ChrisBall/ToffeePhonic/README.md

### ToffeePhonic

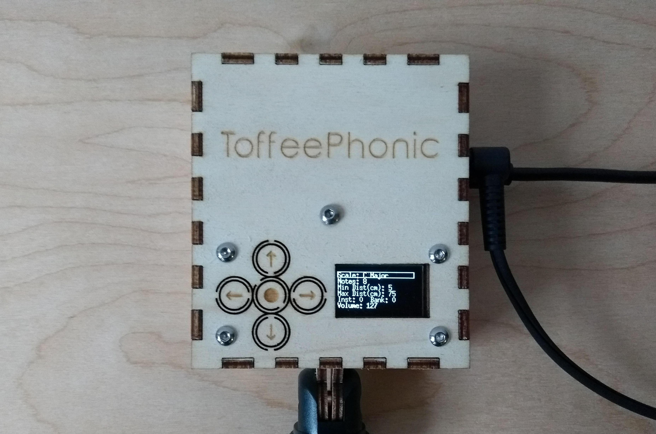
[picture p1: docs/img/000.jpg]
ToffeePhonic


ToffeePhonic is an open-source range sensing instrument. It measures distance using a Time-Of-Flight (TOF) sensor and converts the range into music with it's onboard synthesiser, or sends MIDI out over USB.

The instructions here should contain everything you need to build your own, including a bill of materials, laser cutting files, build guide, code and instructions for use. This project is probably not suitable for complete beginners (at the moment).

[Bill of materials](docs/BOM.md)

[Laser cutting files](docs/LaserFiles.md)

[Build guide](docs/Build.md)

[Code](docs/firmware/ToffeePhonic_basic)

[Instructions for use](docs/Instructions.md)

[This project on Github](https://github.com/ChrisBall/ToffeePhonic)

Development of the instrument and this guide has been part-funded by the wonderful [Drake Music](http://www.drakemusic.org/). No liability is assumed for anything! It is your responsibility to assess the safety and suitability of these instructions.
