ChrisBall/ToffeePhonic/docs/img/002.jpg

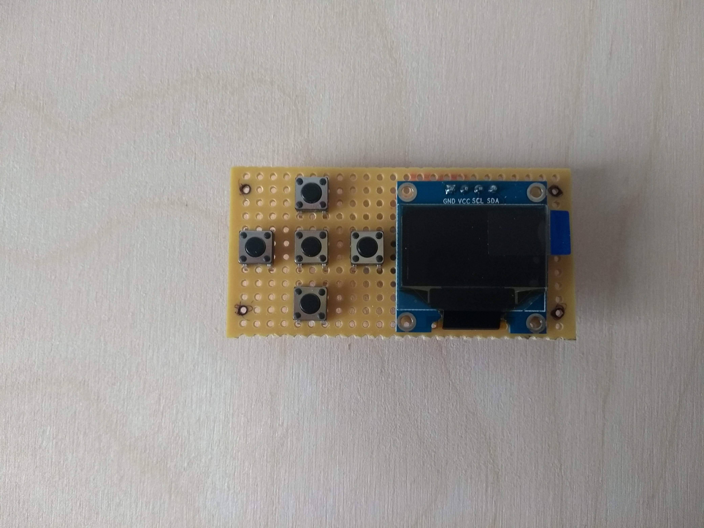
docs/img/002.jpg
