ChrisBall/ToffeePhonic/docs/img/032.jpg

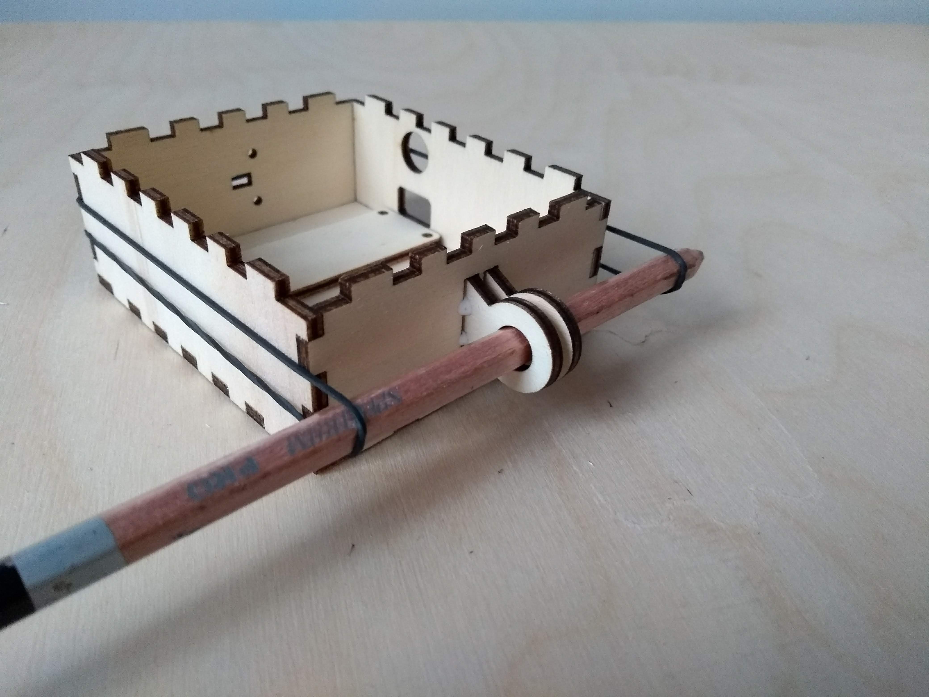
docs/img/032.jpg
