ChrisBall/ToffeePhonic/docs/img/IMG_20181012_145808522.jpg

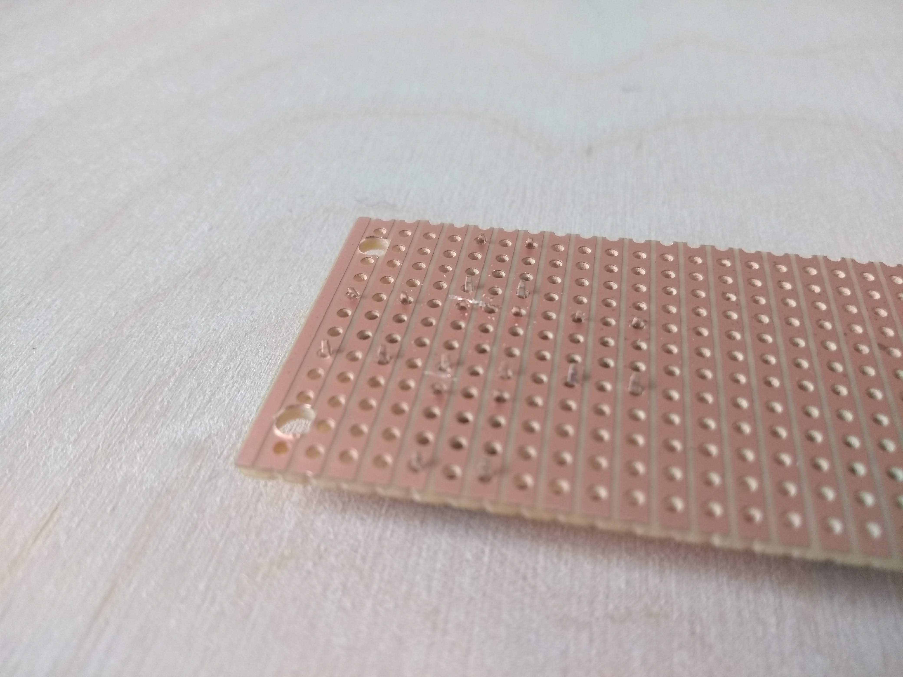
docs/img/IMG_20181012_145808522.jpg
