ChrisBall/ToffeePhonic/docs/img/IMG_20181021_133131997.jpg

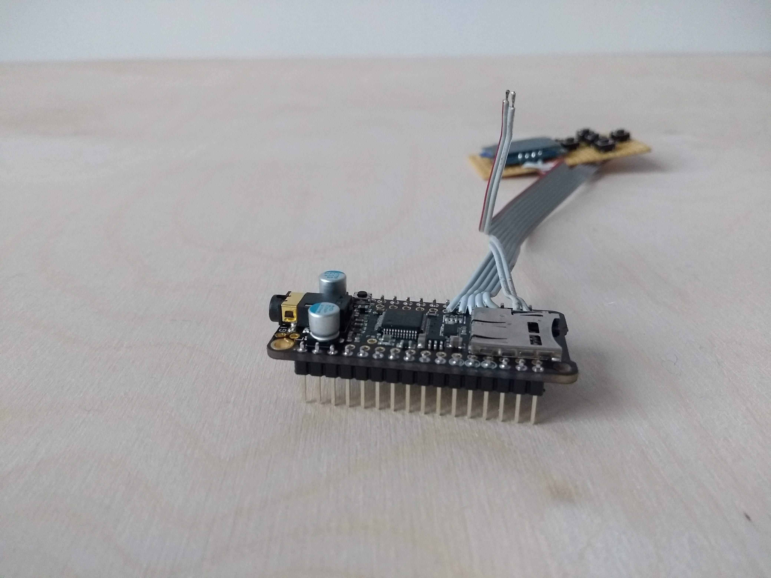
docs/img/IMG_20181021_133131997.jpg
