ChrisBall/ToffeePhonic/docs/img/IMG_20181021_134704607.jpg

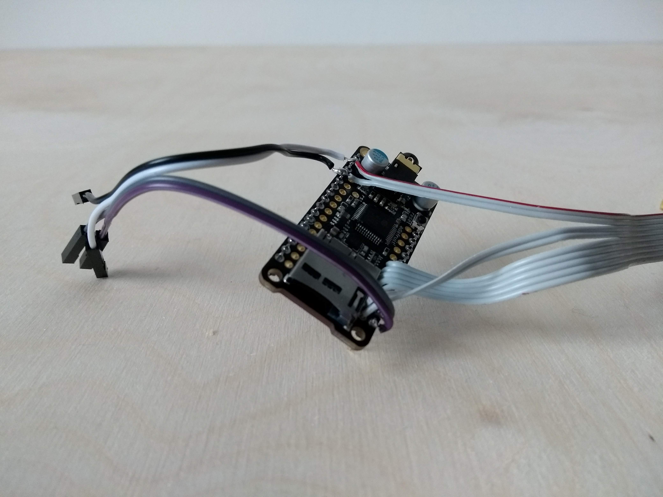
docs/img/IMG_20181021_134704607.jpg
