ChrisBall/ToffeePhonic/docs/img/IMG_20181021_134706835_HDR.jpg

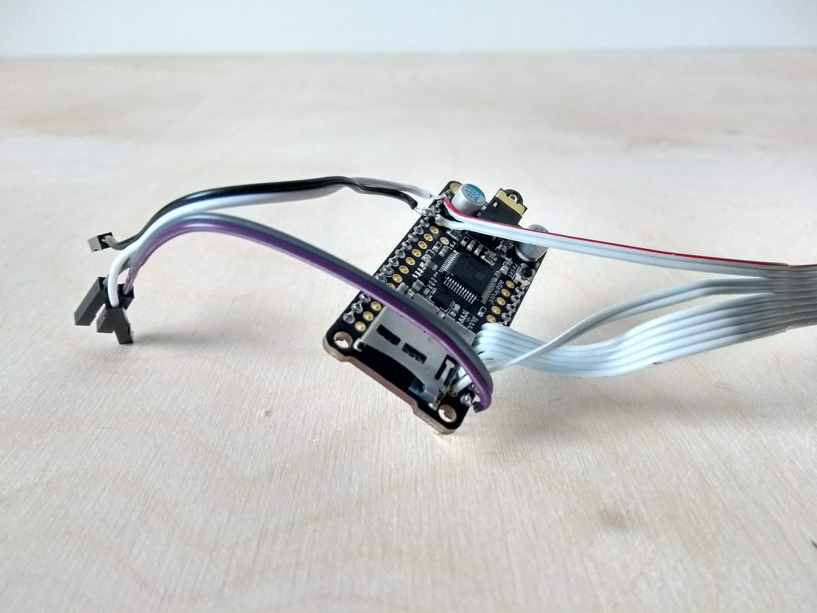
docs/img/IMG_20181021_134706835_HDR.jpg
