ChrisBall/ToffeePhonic/docs/img/IMG_20181021_134756472.jpg

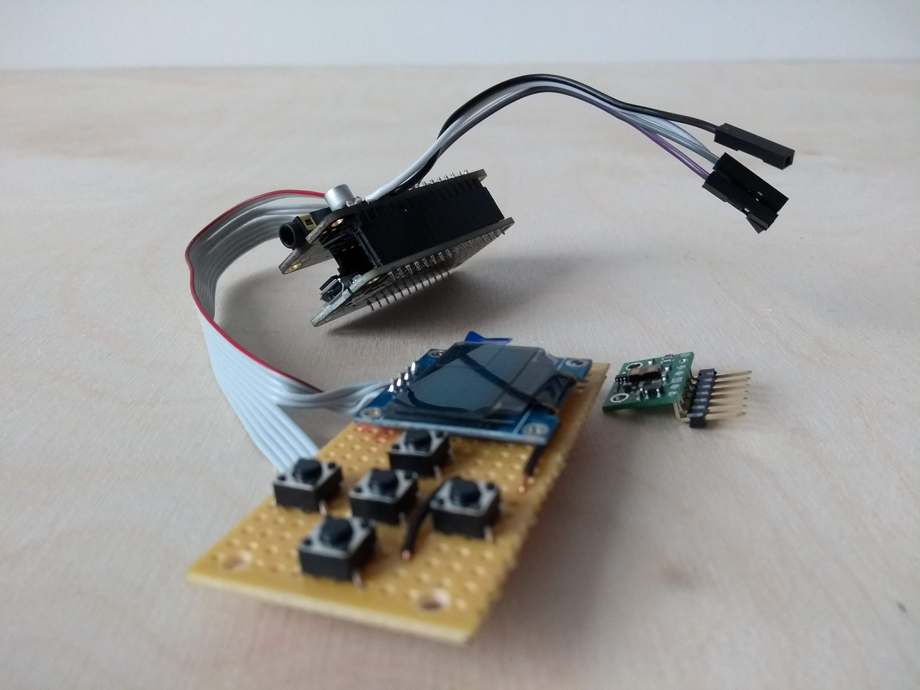
docs/img/IMG_20181021_134756472.jpg
