ChrisBall/ToffeePhonic/docs/img/IMG_20181021_134817264_HDR.jpg

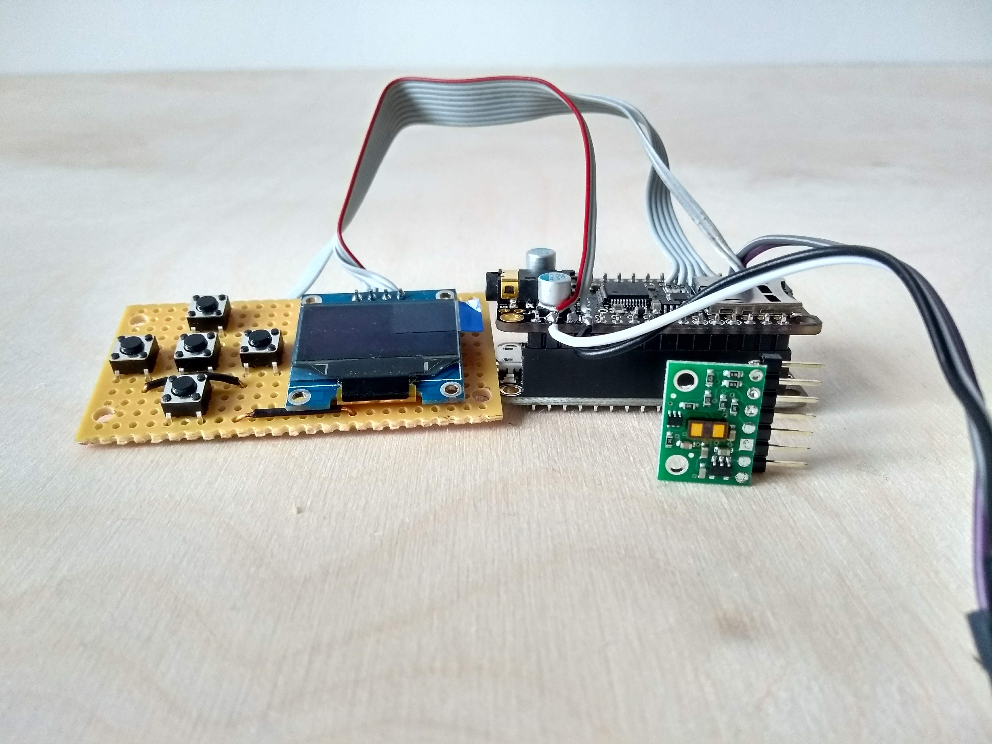
docs/img/IMG_20181021_134817264_HDR.jpg
