ChrisBall/ToffeePhonic/docs/img/IMG_20181021_154531694_HDR.jpg

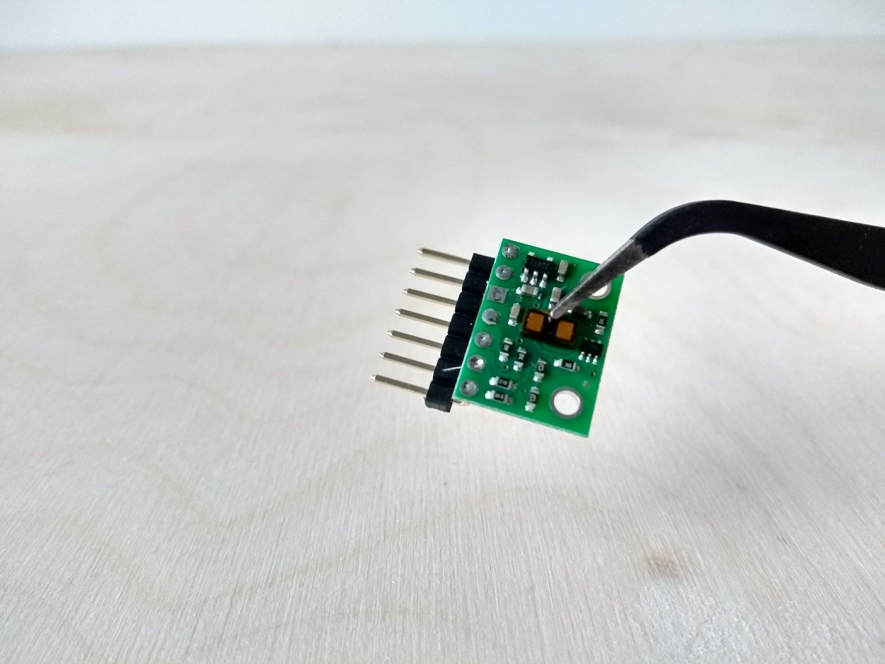
docs/img/IMG_20181021_154531694_HDR.jpg
