ChrisBall/ToffeePhonic/docs/img/IMG_20181021_161038249.jpg

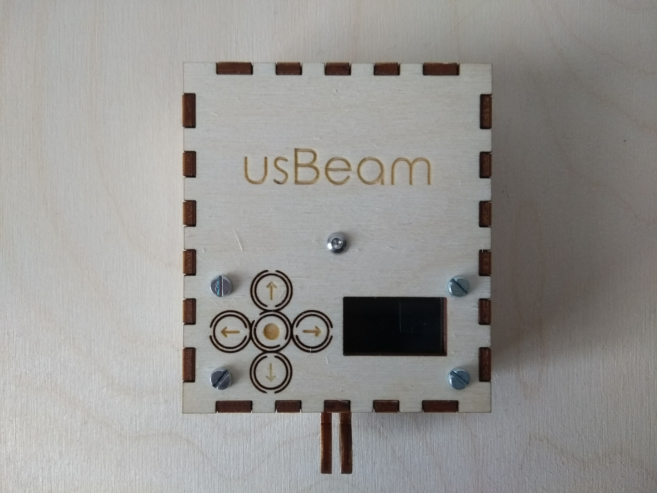
docs/img/IMG_20181021_161038249.jpg
