ChrisBall/ToffeePhonic/docs/img/IMG_20181021_161039607.jpg

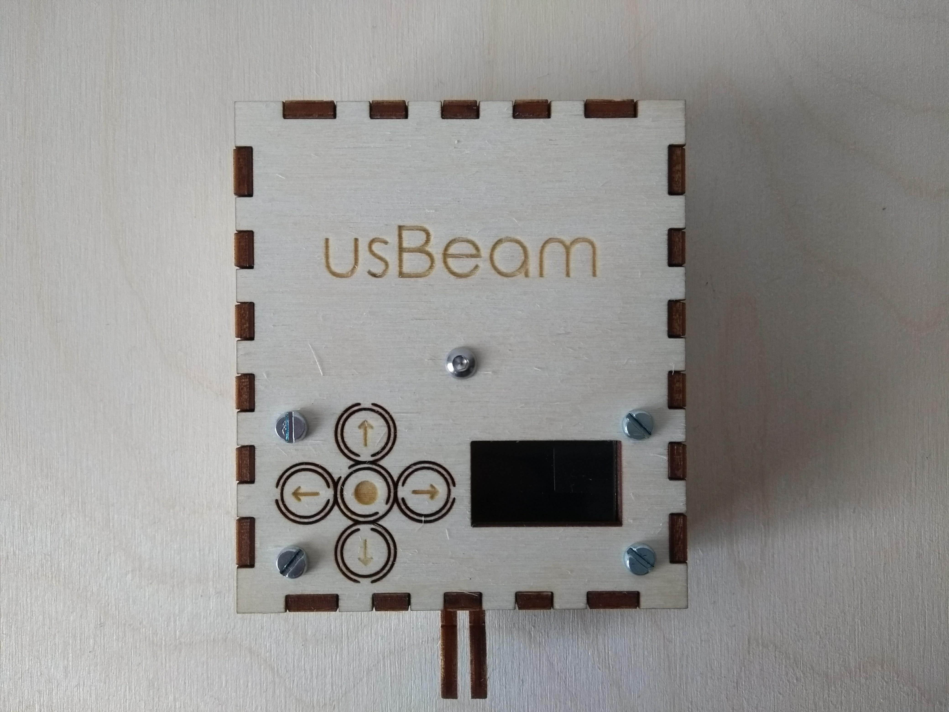
docs/img/IMG_20181021_161039607.jpg
