ChrisBall/ToffeePhonic/docs/img/IMG_20181021_161042068.jpg

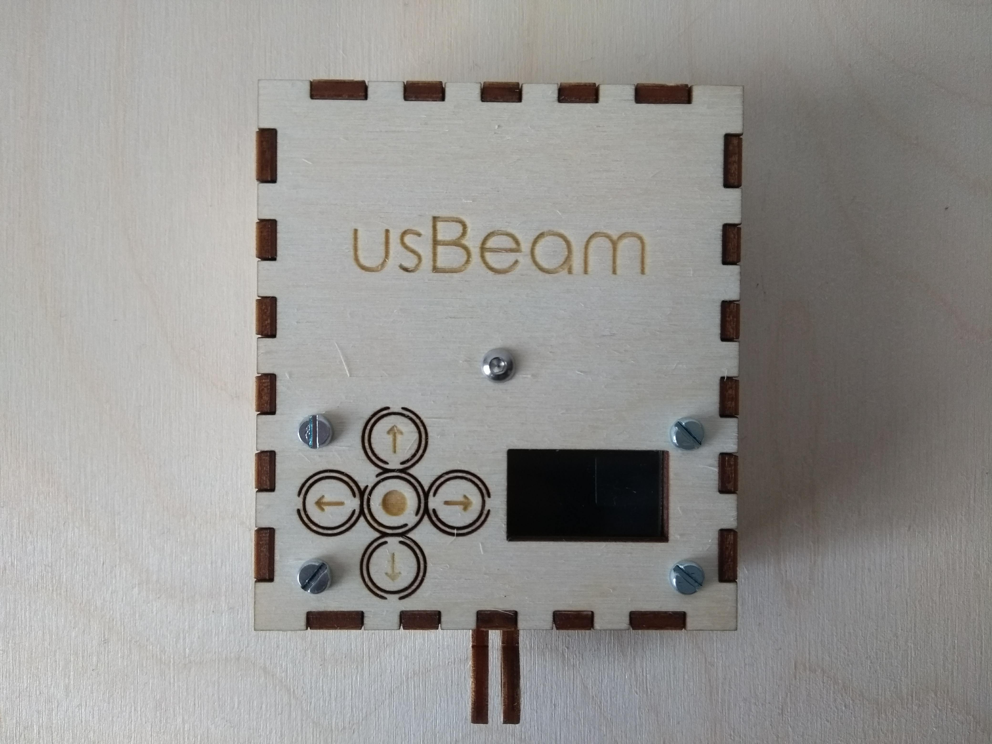
docs/img/IMG_20181021_161042068.jpg
