ChrisBall/ToffeePhonic/docs/img/IMG_20181021_161052201.jpg

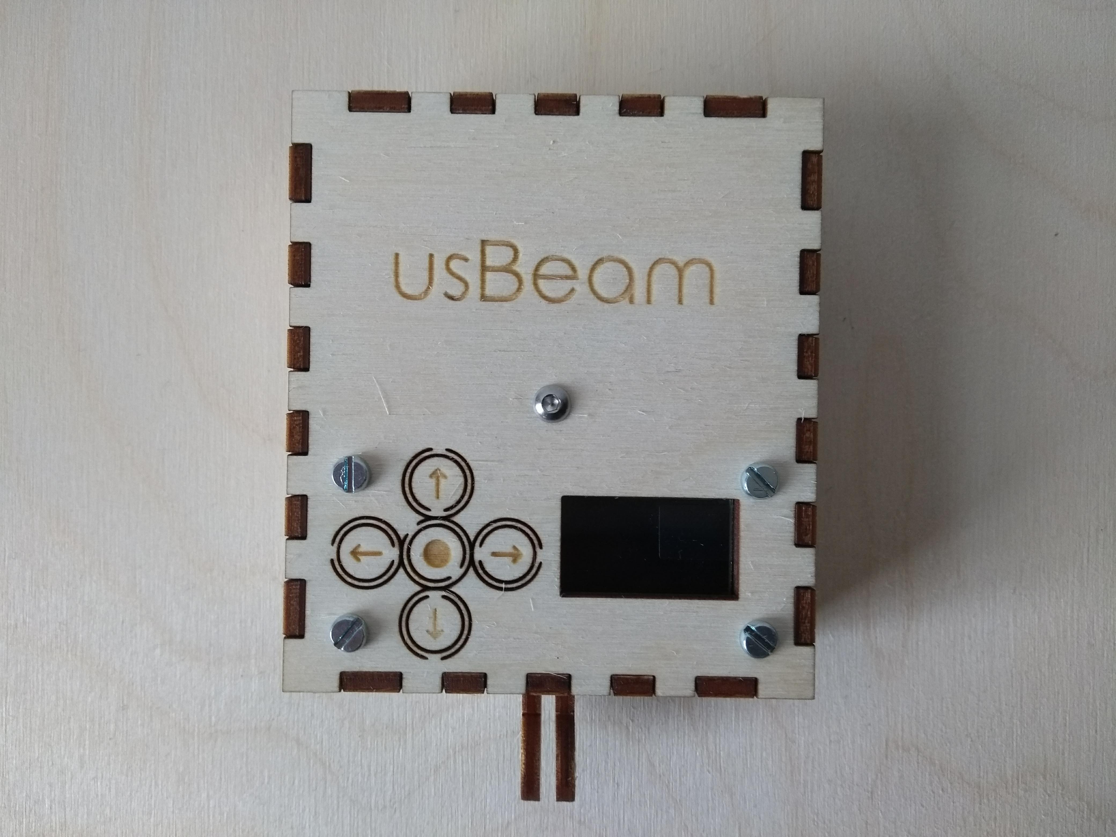
docs/img/IMG_20181021_161052201.jpg
