ChrisBall/ToffeePhonic/docs/img/IMG_20181021_161112957.jpg

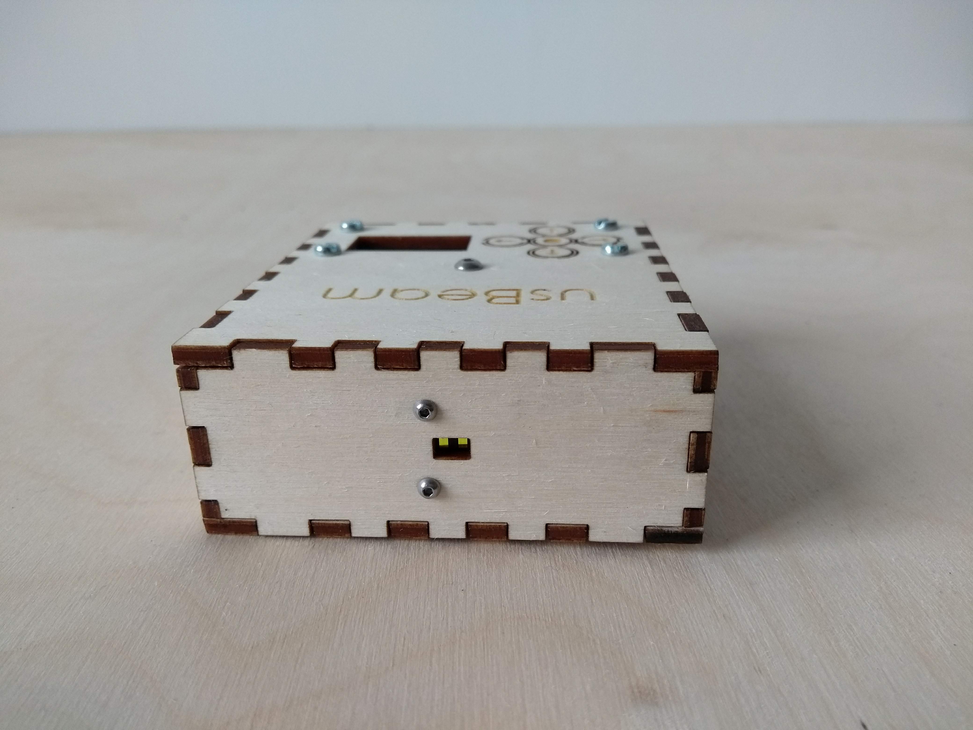
docs/img/IMG_20181021_161112957.jpg
