ChrisBall/ToffeePhonic/docs/img/IMG_20181109_150431618_BURST000_COVER_TOP.jpg

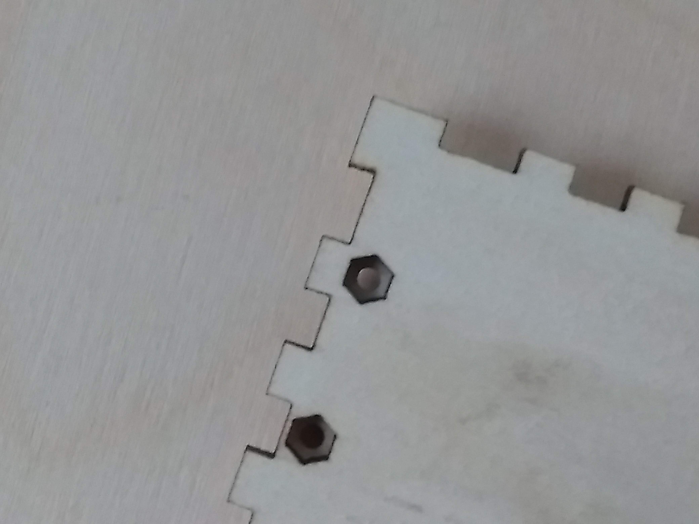
docs/img/IMG_20181109_150431618_BURST000_COVER_TOP.jpg
