ChrisBall/ToffeePhonic/docs/img/IMG_20181109_150909038.jpg

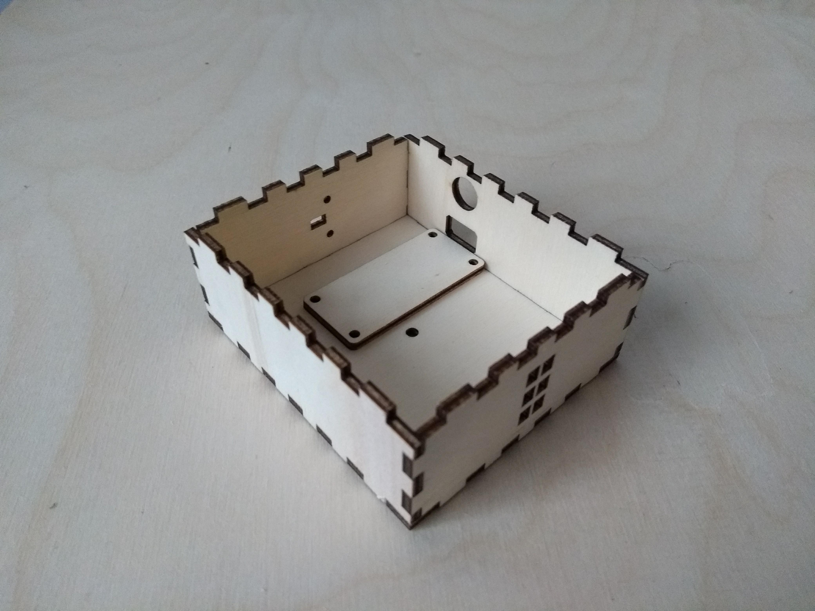
docs/img/IMG_20181109_150909038.jpg
