ChrisBall/ToffeePhonic/docs/Build.md

## Build guide

Menu Breakout (this will hopefully be replaced by a single PCB in future versions):

1. Cut/snap a piece of copper stripboard (0.1" spacing) so you have 24 x 12 holes to work with, with the strips running in the direction of the short sides. We will be placing the components on this board as shown.

    Component placing

2. Drill (to 3mm) the 4 holes at (1,2), (24,2), (1,11), and (24,11) - as pictured.

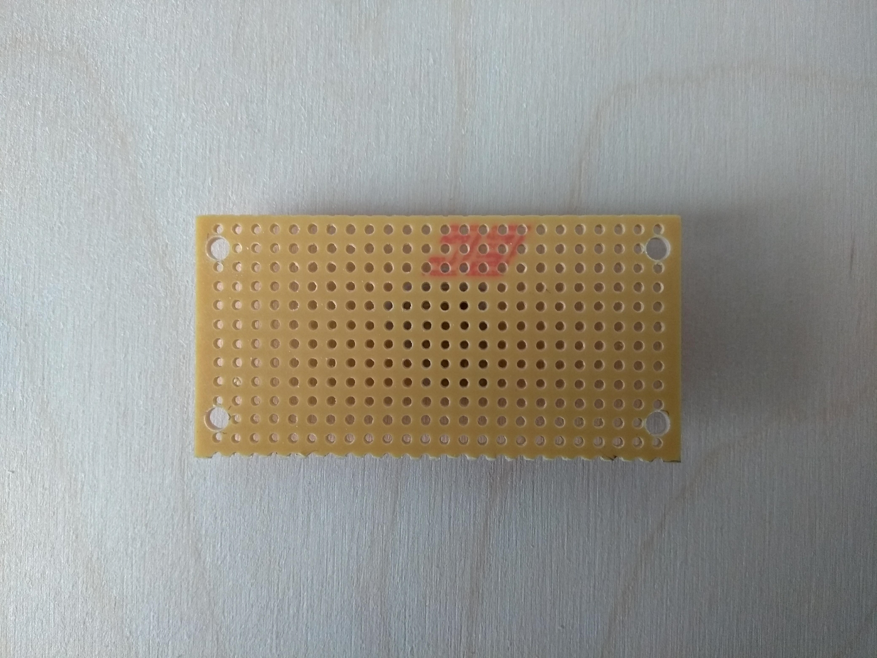
[picture p19: docs/img/001.jpg]
Drill 3mm holes in board
    

3. Put the buttons in place (don't solder them yet), with their top left pins in positions (1,5), (5,1), (5,5), (5,9), (9,5), as pictured in the first image.

4. Carefully, cut the copper tracks with the craft knife: between holes (5,4) and (5,5); and (5,8) and (5,9) (highlighted in the picture).

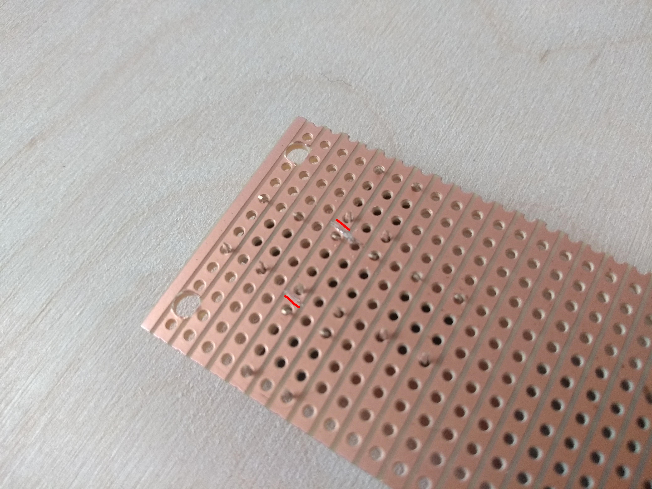
[picture p20: docs/img/004.jpg]
cutting tracks between buttons
    

5. Solder the buttons in place. Make sure they're flush with the board, and that the solder does not spill over the cut track.

6. Remove the plastic spacer from the I2C OLED display. Usually I begin by (carefully) levering this off with some wire cutters and pull it off with pliers once it's loose. Be warned - the glass corners of the OLED display are VERY fragile and can stop the display from functioning if broken. It's a good idea to inspect your display as you open it in case it's been damaged during transit.

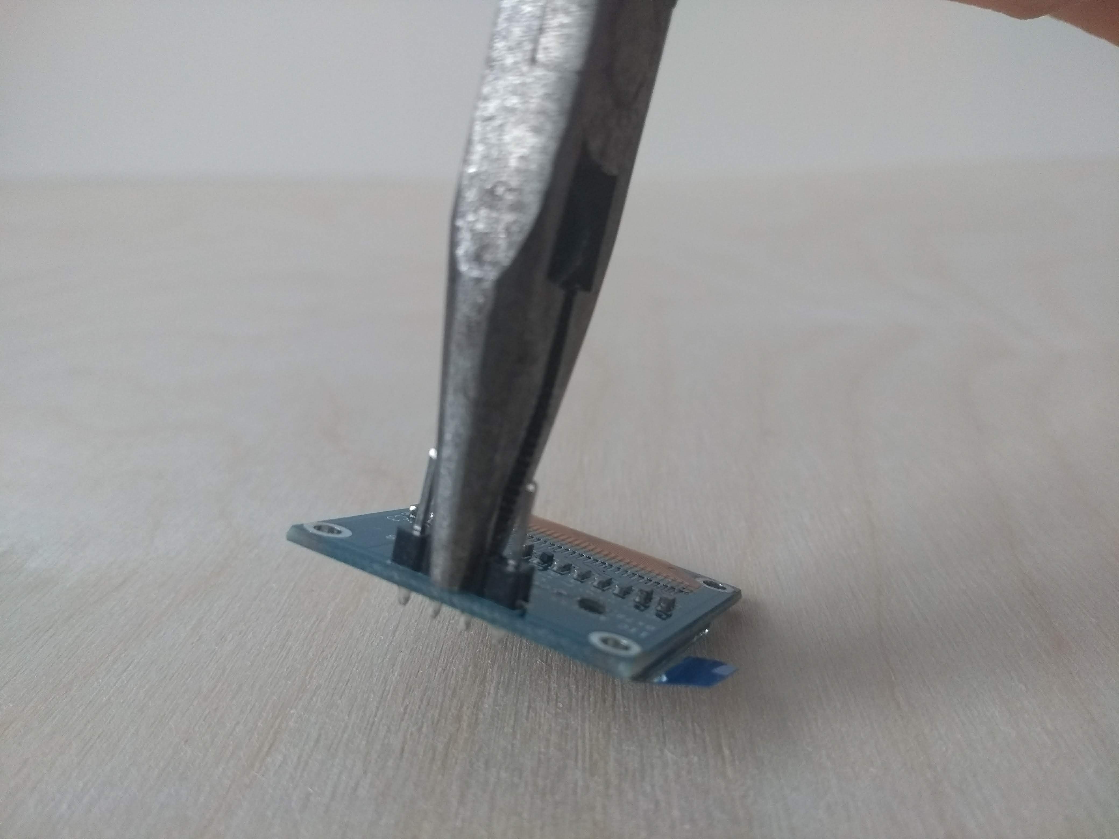
[picture p21: docs/img/005.jpg]
removing header spacer
    

7. Solder the OLED in place - the GND pin should be in position (16,2), as below. Try to keep the OLED as far to the left as you can - this small distance will help prevent the OLED from touching the mounting hardware later.

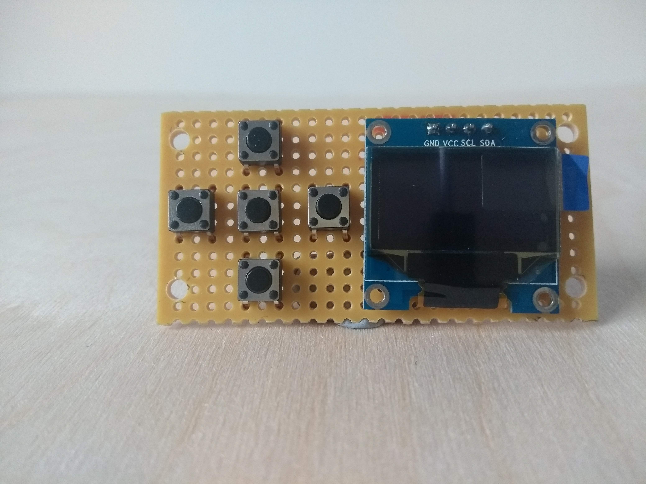
[picture p22: docs/img/006.jpg]
Soldering OLED
    

8. The rear of your board should now look like this:

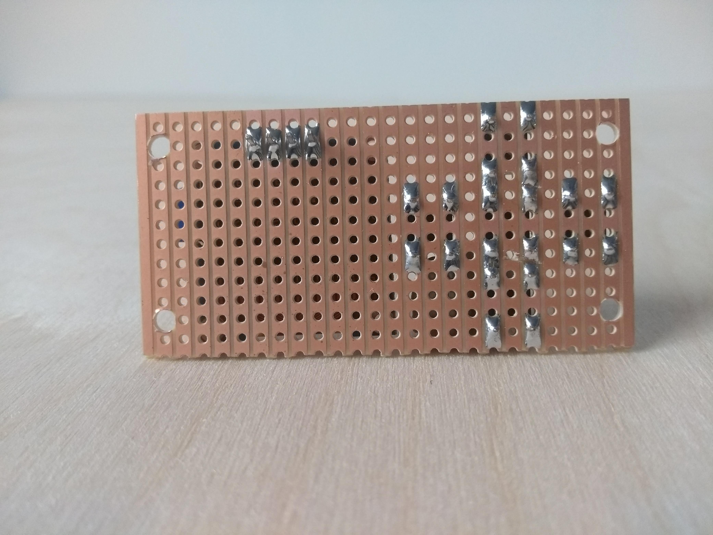
[picture p23: docs/img/007.jpg]
Board rear after soldering OLED and buttons
    

9. Solder in the ground connections - there is one between your OLED GND strip (strip 16) and the left side of the right menu button (strip 9), and one between strip 9 and strip 3. Add solder between strip 9 and strip 7 to complete the GND connections.

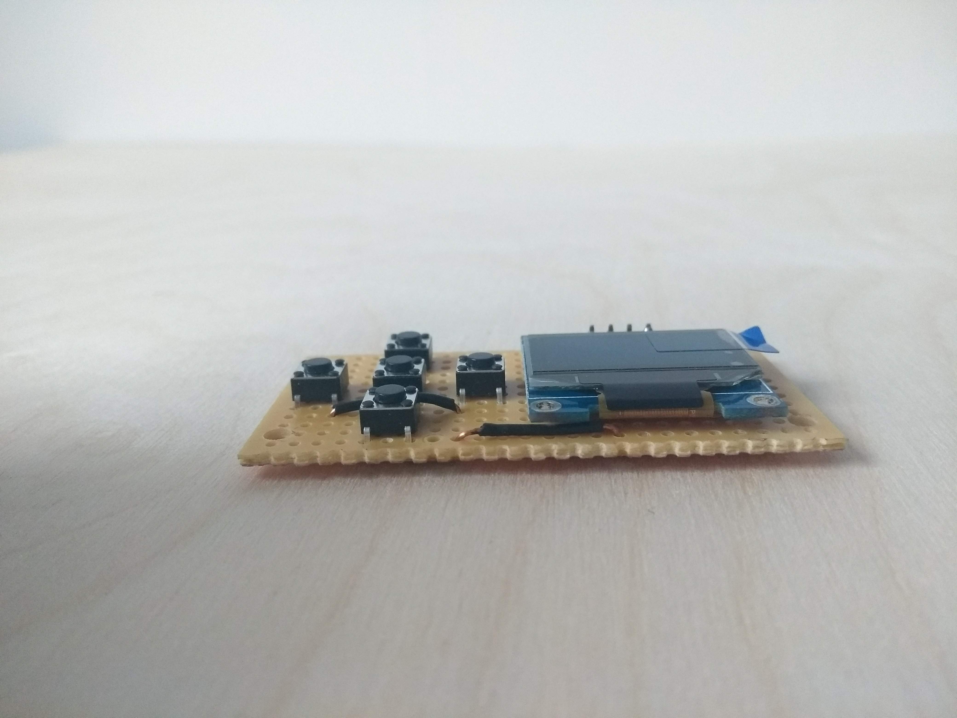
[picture p24: docs/img/008.jpg]
    

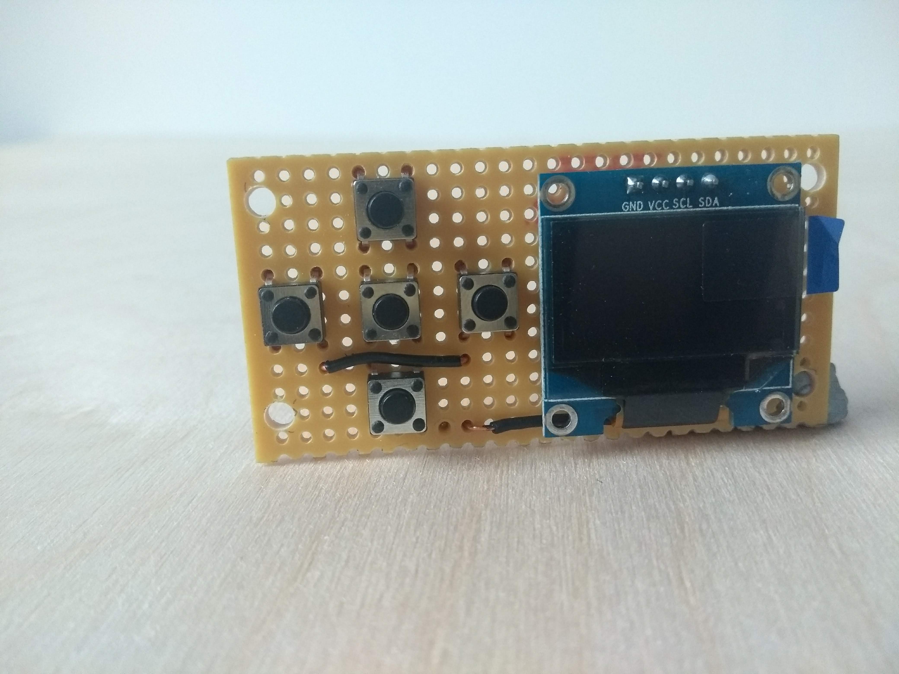
[picture p25: docs/img/009.jpg]
    

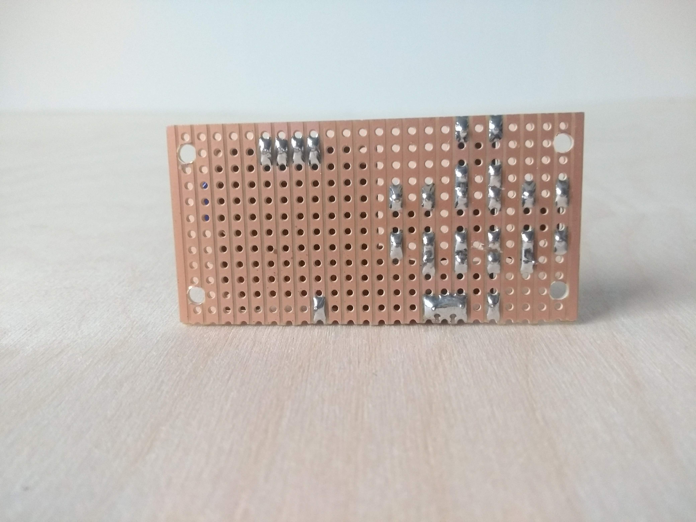
[picture p26: docs/img/010.jpg]
    

10. Prepare your ribbon cable - pull the wires apart a little, and strip about 2-3mm off the end of each wire and tin with solder.

11. Begin soldering connections between the ribbon cable at the menu board. We need to connect the four OLED pins (GND, VCC, SCL, SDA) and another five for the non-GND side of each switch - we will be using the arduino's internal pullups to read the switch state. Here I've used the only red wire on my cable for VCC and the others depending on which wire seemed closest. The order you use doesn't matter too much, as long as YOU know which wire is connected to what. I recommend writing this down as you go.

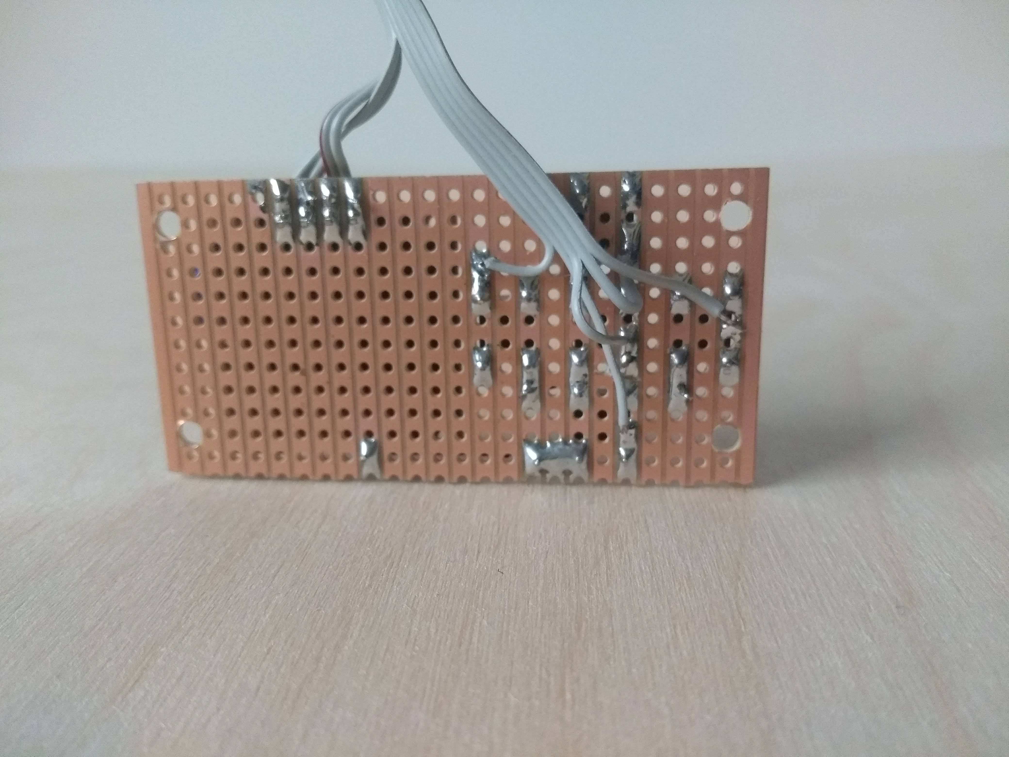
[picture p27: docs/img/011.jpg]
Wired connections
    

    That's it, your menu board is finished! 

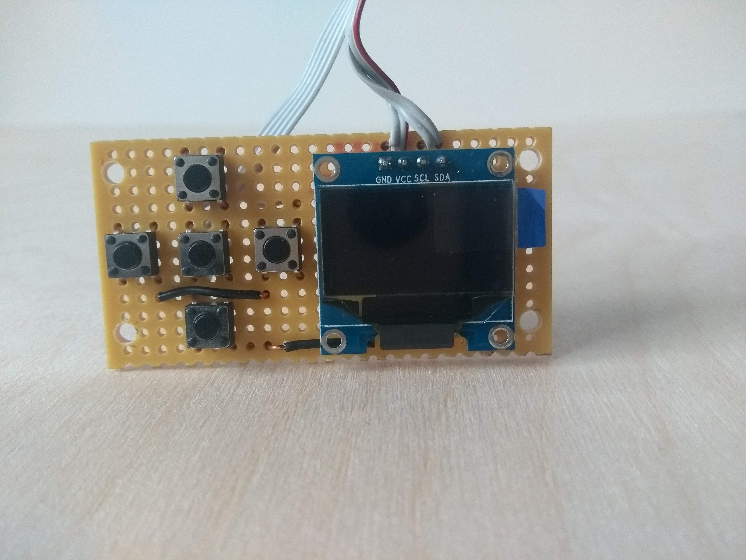
[picture p28: docs/img/012.jpg]
Completed menu board
    

# Microcontroller and Feather wing music maker shield

1. Take your breakaway header sockets and cut them to the lengths of the long rows on each side of the Feather 32u4 proto

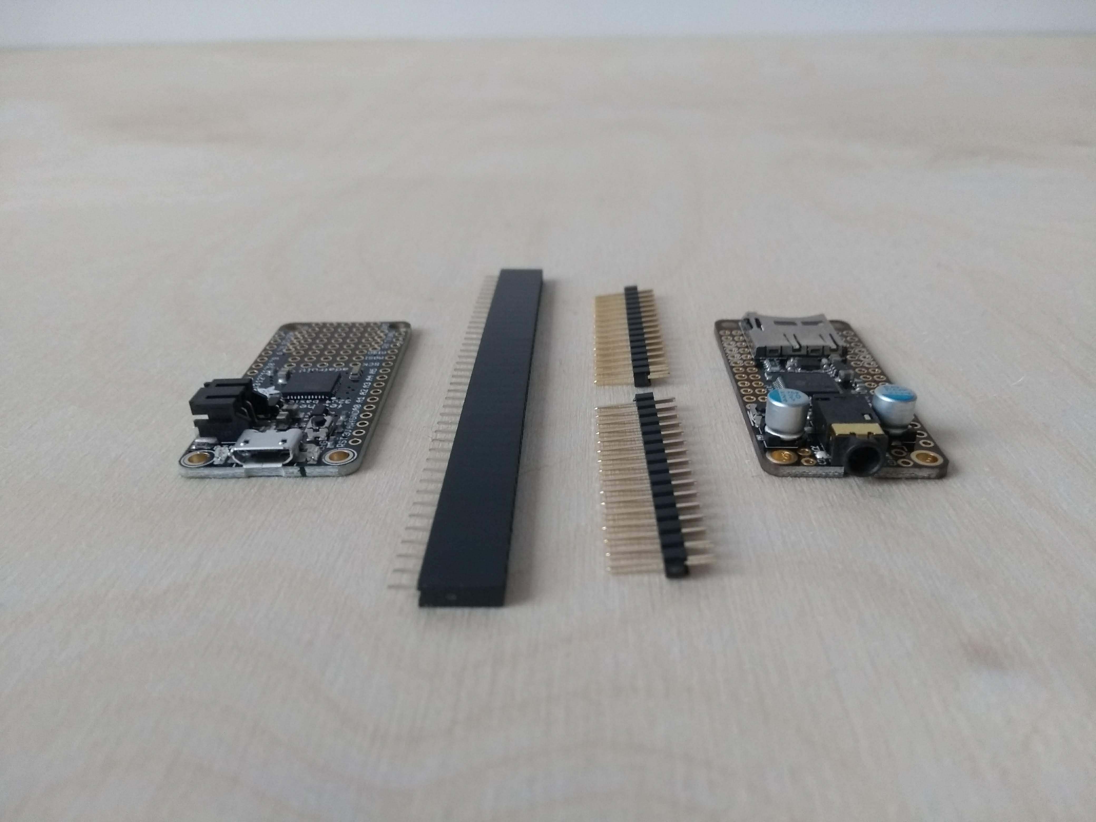
[picture p29: docs/img/013.jpg]
Feather 32u4, music maker wing and headers
    

2. Solder them onto the board, as pictured. Make sure they're flush and straight.

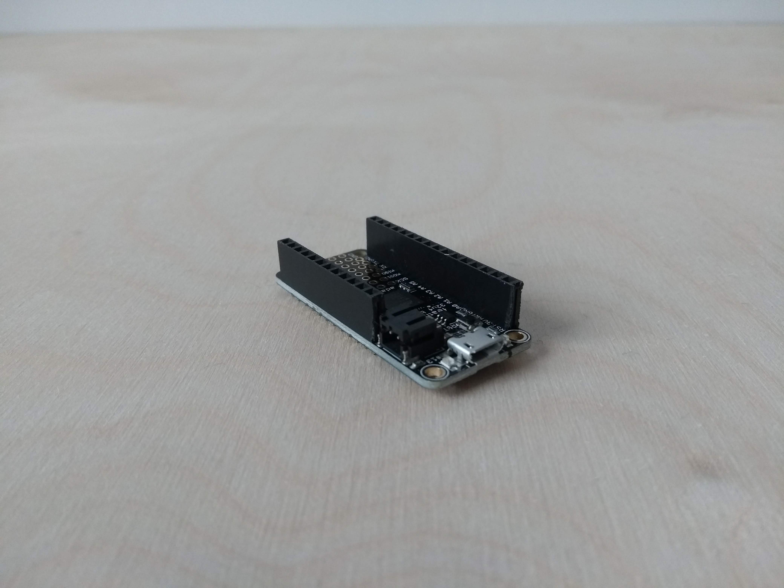
[picture p30: docs/img/014.jpg]
Feather 32u4 and header sockets
    

3. Solder the corresponding header pins onto the Feather Wing Music Maker.

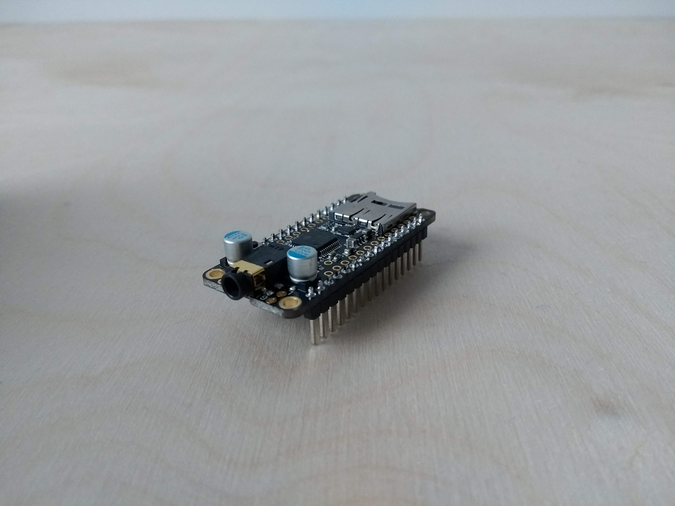
[picture p31: docs/img/015.jpg]
Music maker wing and header pins
    

4. If you haven't done so already, prepare the Feather Wing Music Maker for MIDI mode by bridging the solder jumper marked "MIDI" on the underside of the board.

5. Check they fit nicely together.

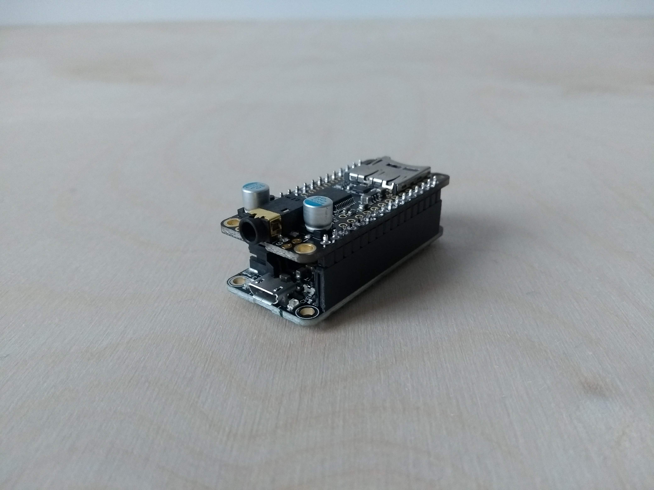
[picture p32: docs/img/016.jpg]
Controller & synthesiser assembly
    

# VL53L1X setup

1. Solder the right angled headers (these should come with the module) into the board, as pictured. We don't want the pins to stick out too much on the component side, as they will get in the way later, when mounting the module to the enclosure.

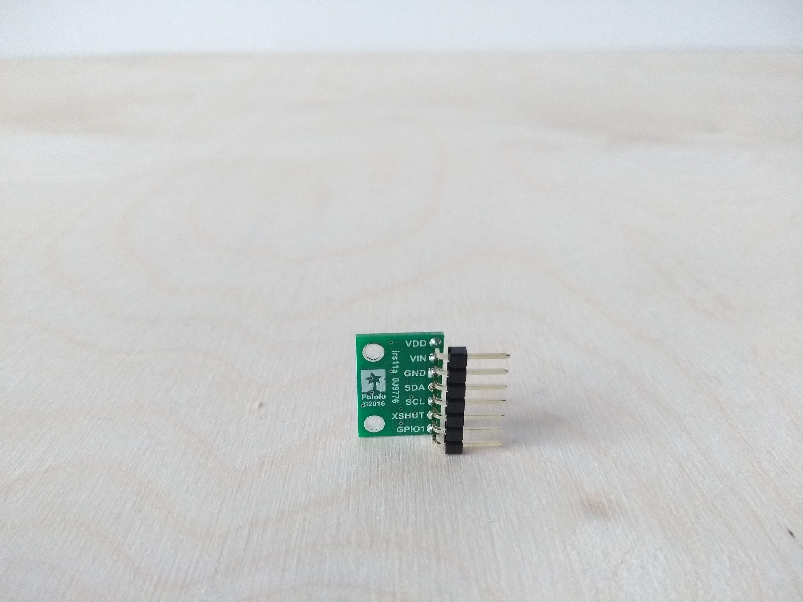
[picture p33: docs/img/017.jpg]
    

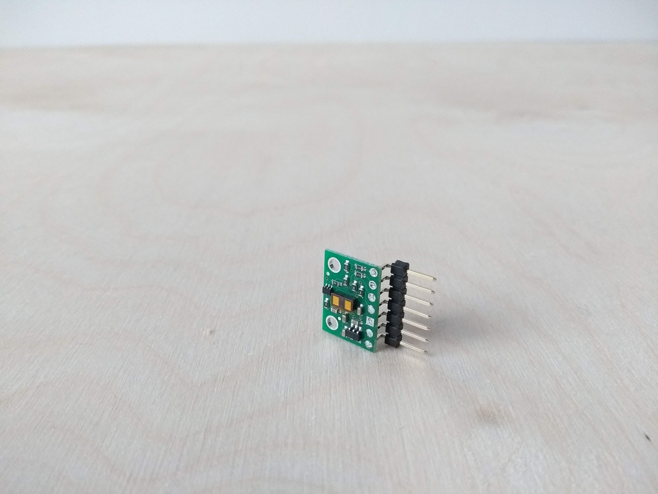
[picture p34: docs/img/018.jpg]
    

# Putting it all together

1. Start by soldering the five wires from your menu board to the Feather Wing Music Maker. Wire should be connected from buttons: left, up, center, down, right to pins 5,6,9,10 and 11 respectively. Don't worry too much about getting this exact order - if you make a mistake you should be able to fix it later in software. You may have to refer to the Feather 32u4 proto for the pin numbering as they're not printed on the music maker shield. 

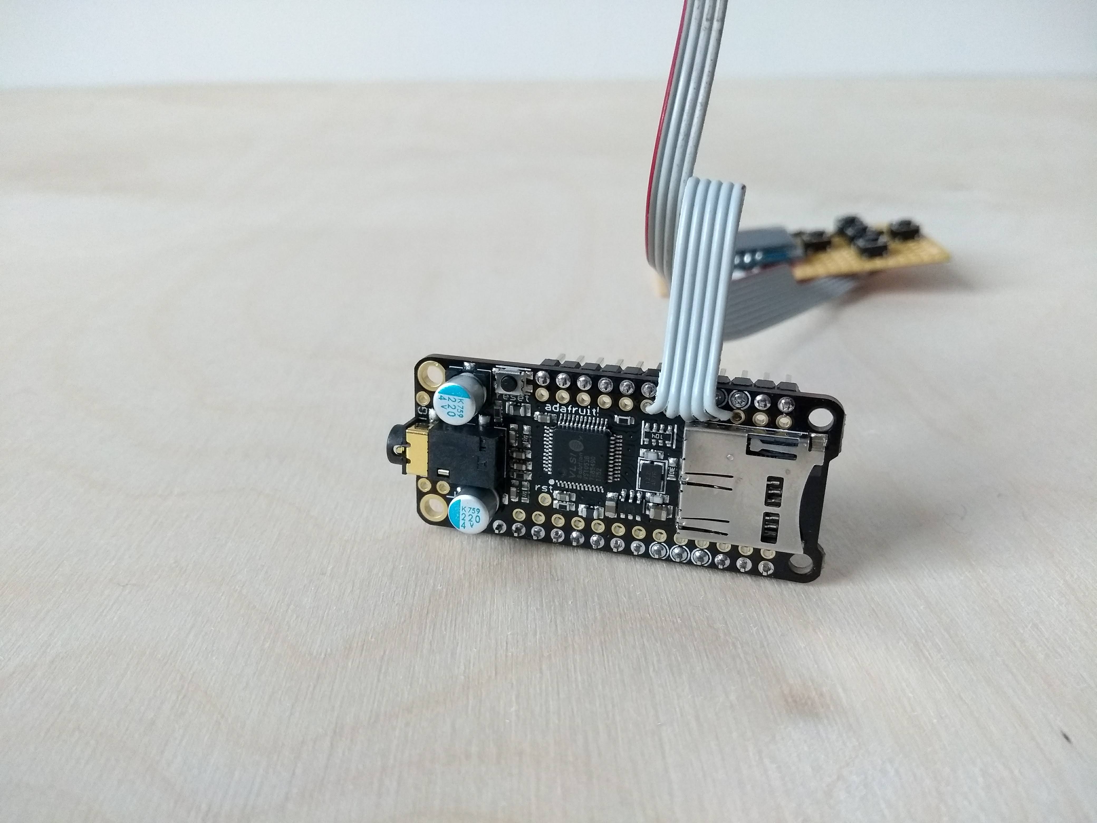
[picture p35: docs/img/019.jpg]
    

2. Then, connect the SDA and SCL from your OLED to SDA and SCL on the Feather Wing Music Maker.

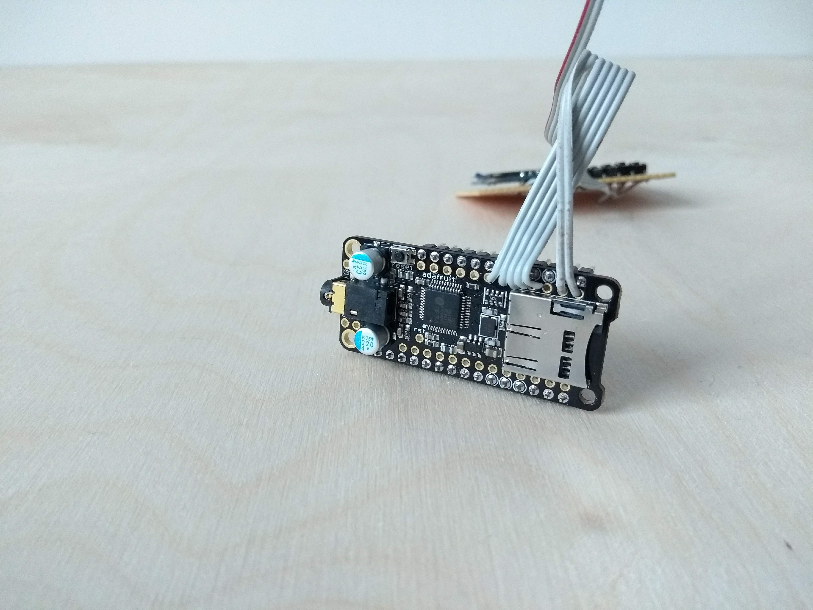
[picture p36: docs/img/020.jpg]
Connecting menu I2C
    

3. Finally, connect VCC and GND from your OLED to 3V3 and GND on the Feather Wing Music Maker. Your menu board is now connected.

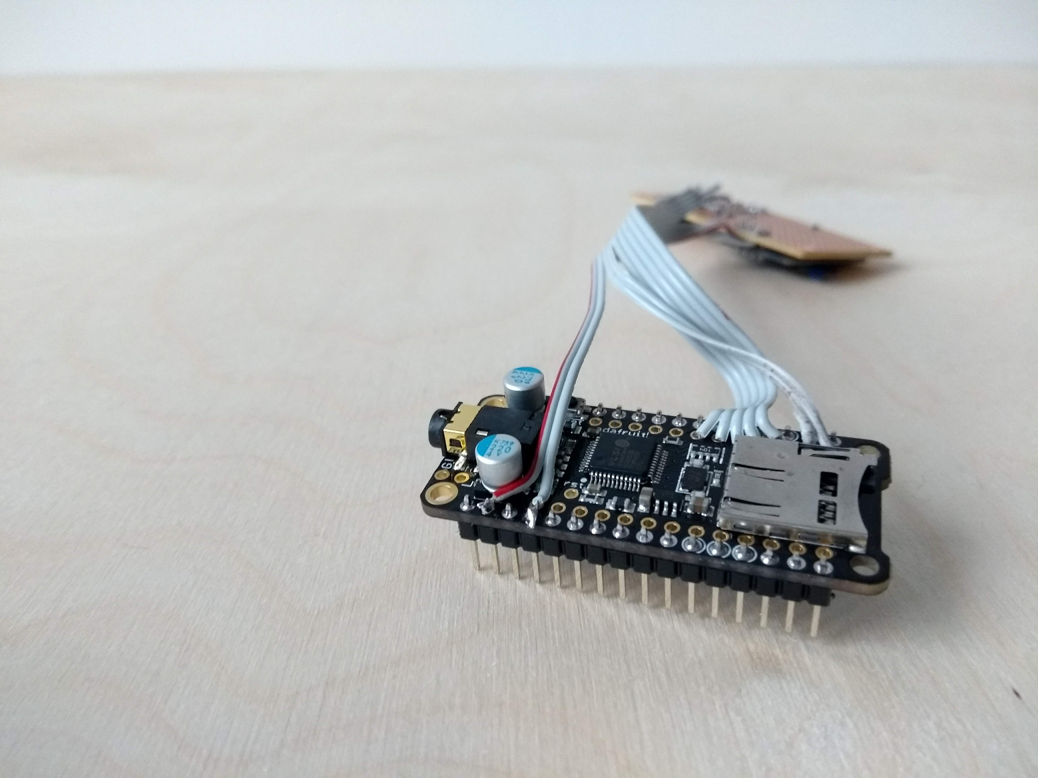
[picture p37: docs/img/021.jpg]
    

4. Using 4 dupont jumper wires, cut the (non female) ends off - we'll be using these to connect the VL53L1X Time-Of-Flight Sensor to the main boards - leave as much length as you can (because it's better than them being too short).

5. Solder the four wires to SDA, SCL, 3V3 , and GND on the Feather Wing Music Maker. Again, it doesn't matter which colour is which, as long as YOU know.

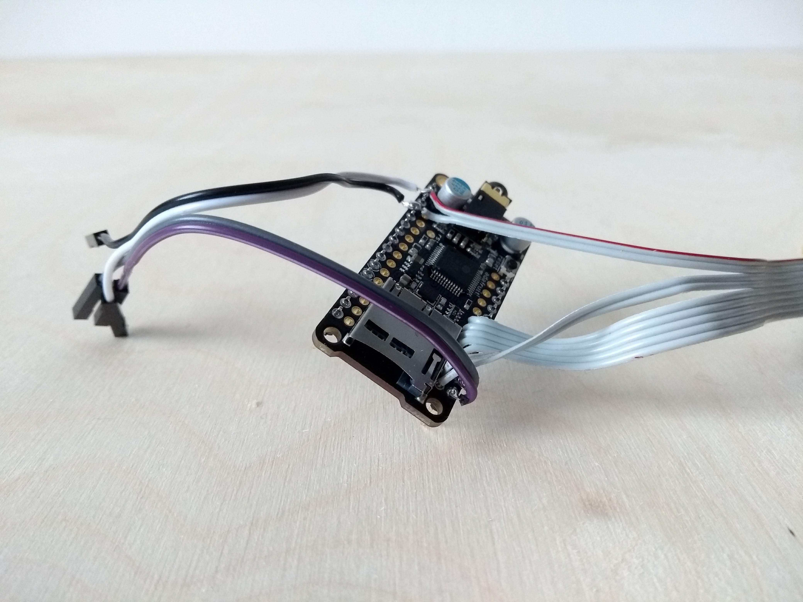
[picture p38: docs/img/022.jpg]
Connecting VL53L1X wires
    

6. Connect these four wires: SDA, SCL, 3V3, GND, to the following pins on your VL53L1X breakout: SDA, SCL, VIN, GND (respectively).

7. If the Feather Wing Music Maker is not connected to your Feather 32U4, do so now.

    That's all the electronics parts done! You may wish to program and test this now, before we put it into the case to identify any problems. 

# Programming

1. Download the arduino code [here](https://github.com/ChrisBall/ToffeePhonic/blob/master/docs/firmware/ToffeePhonic_basicu).

2. Download the arduino IDE (if you don't already have it) [here](https://www.arduino.cc). There are also three library dependencies not included with arduino:

[ScaleManager](https://github.com/ChrisBall/ScaleManager)

[U8G2](https://github.com/olikraus/u8g2)

[Polulu VL53L1X](https://github.com/pololu/vl53l1x-arduino)

3. In the arduino IDE, add the following text to your "Additional boards manager URLs" in the File->preferences menu:

    "https://adafruit.github.io/arduino-board-index/package_adafruit_index.json"

    this will add all the adafruit manufactured boards to your Tools->Board menu.

4. Select "Adafruit Feather 32U4" from the boards menu.

5. Upload the code to the board. You may need to press the reset button to initiate an upload.

6. You should see the menu on the OLED display, and be able to control it from the buttons. If you need to change the button order, find the line:

```c++
const byte buttonPins[] = {6,5,9,11,10}; //UP, LEFT, CENTRE, RIGHT, DOWN   
```

and swap the pin numbers as necessary.

7. If you connect some headphones or a line out to an amplifier, you should hear sounds when you interact with the VL53L1X sensor, and receive MIDI over the MIDI USB device that appears.

# Enclosure

1. Using a laser cutter, cut the parts from this file: [Laser Cutting Files](docs/LaserFiles.md). Use the ToffeePhonic_basic_noMicClip if you are not planning to use a Mic attachment to mount your device. In your laser setup, You will need to etch the RED, cut the BLACK, and then cut the BLUE paths, in any 3mm material (I've used 3mm Birch/Poplar laser ply).

2. Glue the rectangular spacer in place on the base. Each hole should line up perfectly with the centre of each hexagon on the base piece.

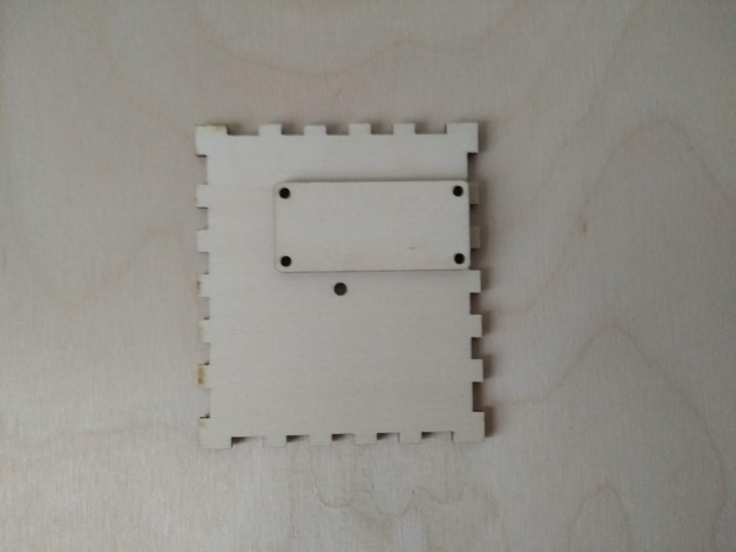
[picture p39: docs/img/030.jpg]
    
	
	You may wish to use your M2 nuts and bolts to make sure the piece is in the correct place.
	
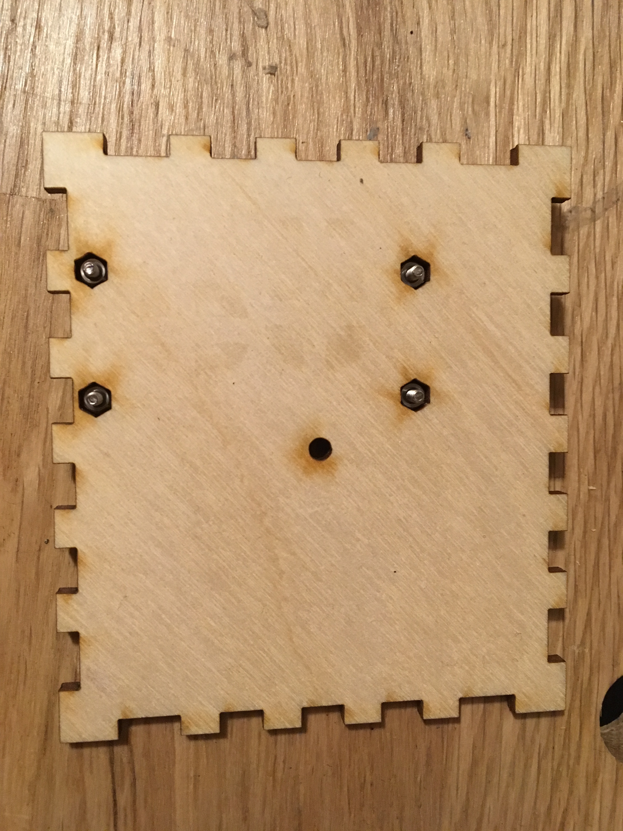
[picture p40: docs/img/030a.jpg]
	

3. Glue together these 5 parts: the two sides, the front and back, and the base.

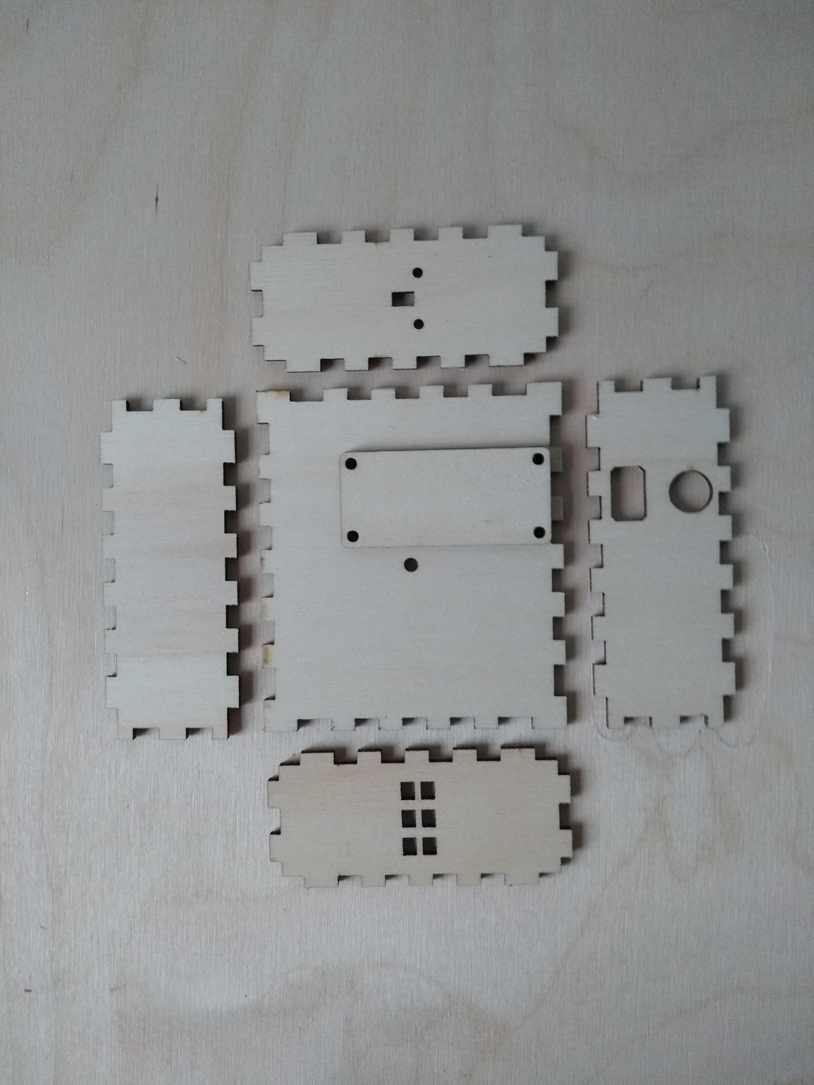
[picture p41: docs/img/031.jpg]
    

4. Use elastic bands the hold the parts in place while the glue sets (it should only take ten minutes for this to set enough to continue). Make sure the sides are straight and fit neatly.

5. If you are using the mic clip version, glue in the two circular clips now. You can use a pencil or pen and another elastic band to hold this in place while the glue sets.

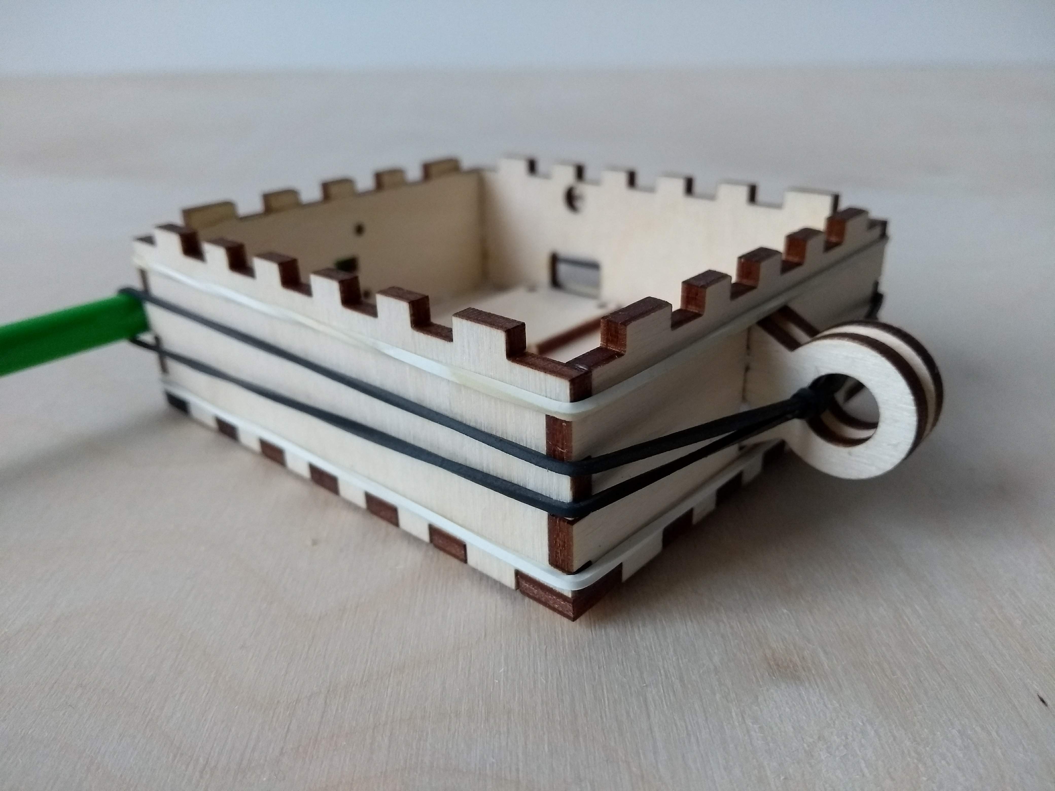
[picture p42: docs/img/023.jpg]
    

6. Screw the motherboard mounting screw into the central hole in the base using your pliers. It should fit tightly, and not come out when tugged (lightly).

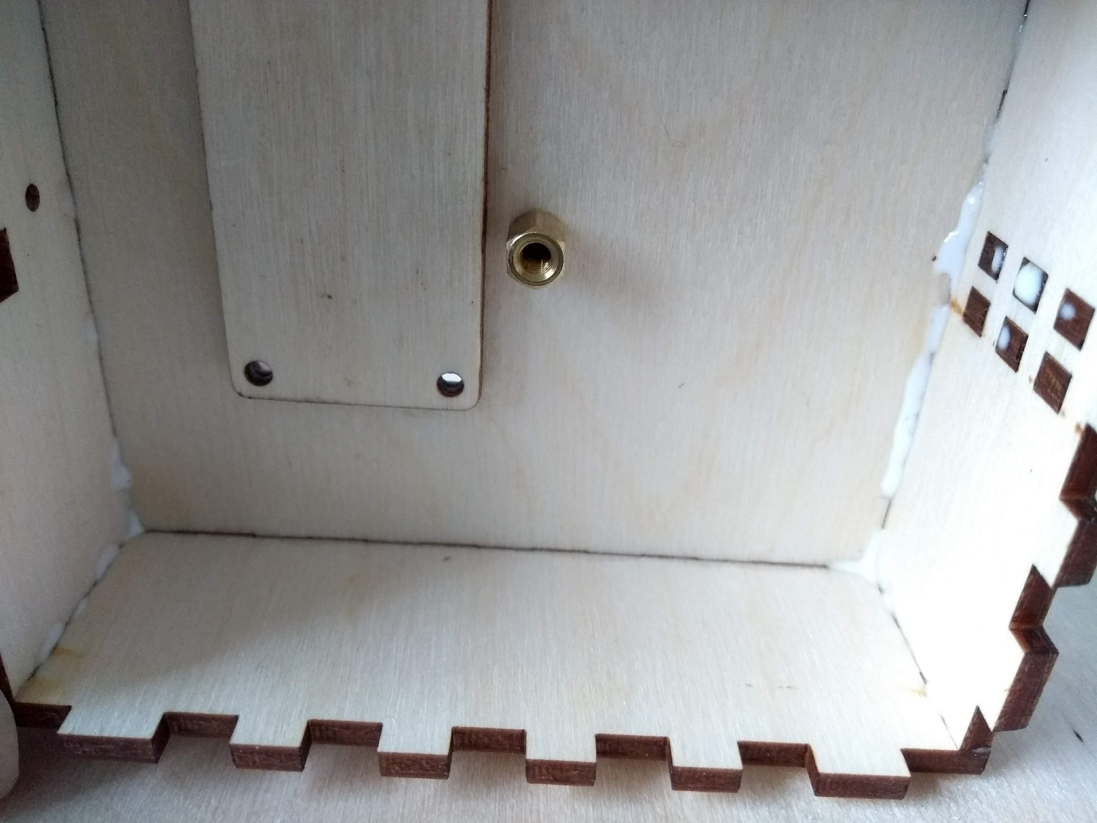
[picture p43: docs/img/024.jpg]
Mounting screw
    

7. Take the front panel, 8 x M3 nuts, and 4 x M3x16 screws. Affix the two nuts as spacers, as shown.

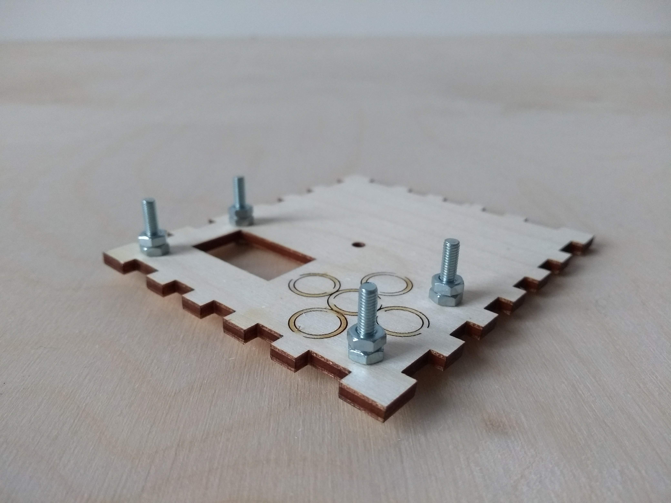
[picture p44: docs/img/025.jpg]
    

8. Line up your menu panel, and push onto the screws as gently as possible. Take real care not to damage the OLED during this process. If there is a problem with fitting (e.g. the OLED is too far over) try reaming out the 3mm holes on the stripboard to a larger size, such as 3.5mm or 4mm. Affix the panel with the last 4 nuts. You should hear and feel a click when you press the buttons.

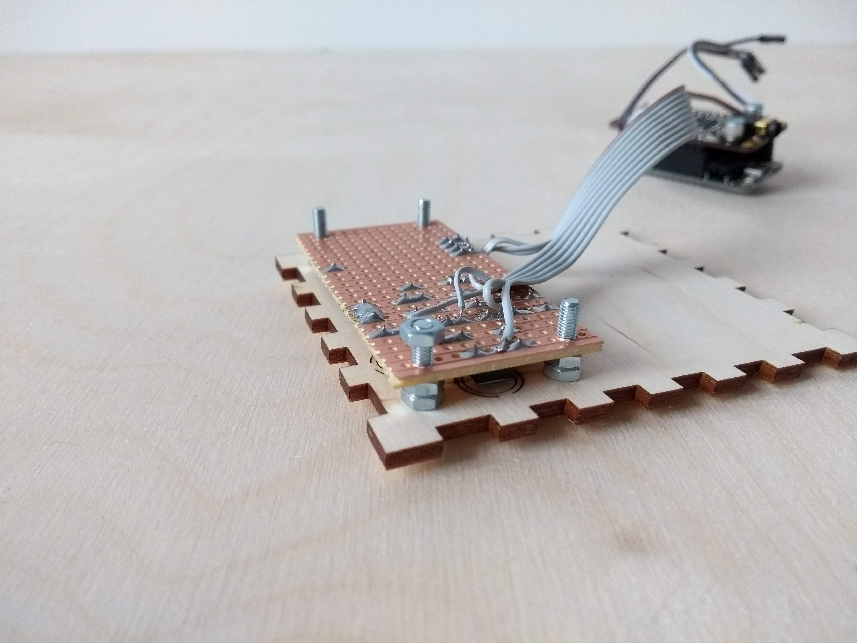
[picture p45: docs/img/026.jpg]
    

9. Mount the feather 32U4 to the rounded rectangle mount with 4 x M2 screws & nuts.

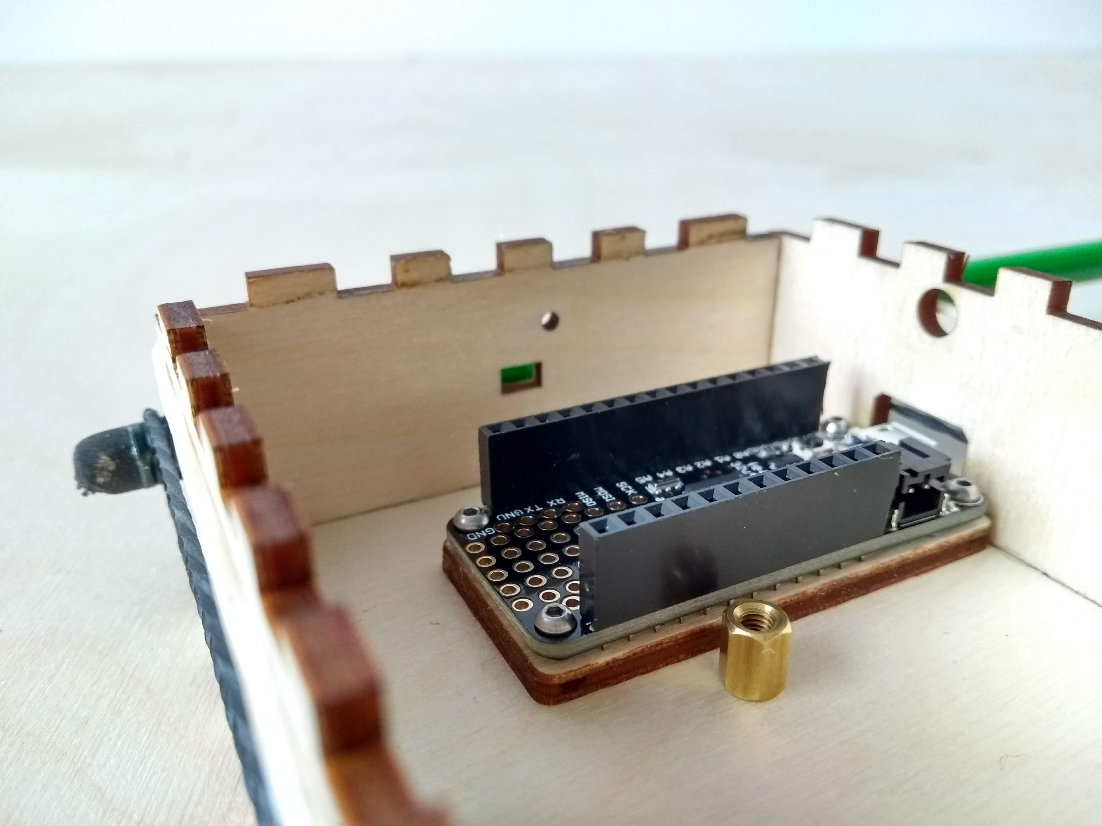
[picture p46: docs/img/027.jpg]
    

10. Mount the VL53L1X module to the front of the case with 2 x M2 screws & nuts. The TOF sensor should fit in the rectangular window, and remember to remove the small orange protective cover from the sensor itself.

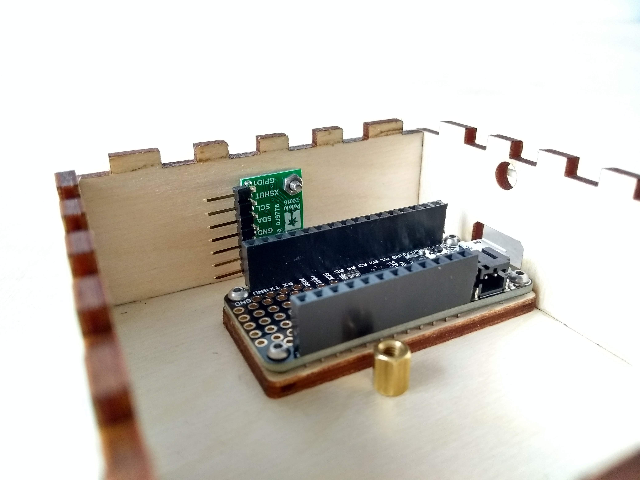
[picture p47: docs/img/028.jpg]
    

11. Connect the wires for the VL53L1X module (if they are not connected already)

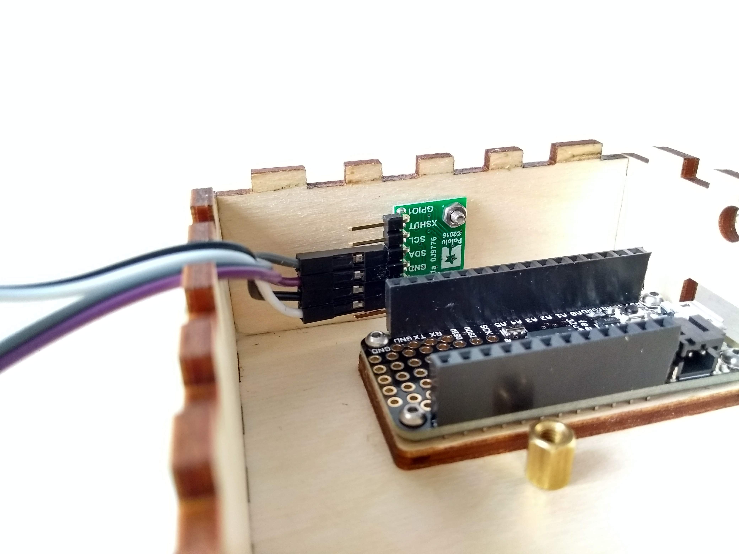
[picture p48: docs/img/029.jpg]
    

12. Insert the MP3 codec module, close the front cover, and insert the final M3 screw, which should hold the cover in place. Add the mic clip. You're done! Take a look at the [instructions](Instructions.md) to get the most from your ToffeePhonic.

    Mounting VL53L1X
