ChrisBall/ToffeePhonic/(threads)

Thread 1 (2020-07-28):

Regular MIDI Hole

designerzen, 2020-07-28:
Really enjoyed your presentation and think it is a lovely idea and a common goal we are working towards 👍 . One thing that I would find super useful is cable MIDI - rather than USB MIDI.

How easy would it be to add a regular old fashioned MIDI socket to the design?

You could still ouput 18 channels of MIDI so in theory one sensor could even be assigned to one MIDI channel!

ChrisBall, 2020-07-28:
It'd be straightforward - the serial port in this device is directly connected to an internal synthesiser (in the form of the VS1053 chip) so it can be used without any other hardware.
I suspect we can just connect this to a MIDI port without any issues.

ChrisBall, 2020-07-28:
I'll take a look at whether there's space to add one to the existing case!
