ChrisBall/ToffeePhonic/docs/firmware/ToffeePhonic_mp3/VS1053.ino

void VS1053setup() {
  if (! musicPlayer.begin()) { // initialise the music player
    Serial.println(F("Couldn't find VS1053, do you have the right pins defined?"));
    while (1);
  }

  if (!SD.begin(CARDCS)) {
    Serial.println(F("SD failed, or not present"));
    while (1);  // don't do anything more
  }
  Serial.println("SD OK!");

  // Set volume for left, right channels. lower numbers == louder volume!
  musicPlayer.setVolume(10, 10);

#if defined(__AVR_ATmega32U4__)
  // Timer interrupts are not suggested, better to use DREQ interrupt!
  // but we don't have them on the 32u4 feather...
  musicPlayer.useInterrupt(VS1053_FILEPLAYER_TIMER0_INT); // timer int
#else
  // If DREQ is on an interrupt pin we can do background
  // audio playing
  musicPlayer.useInterrupt(VS1053_FILEPLAYER_PIN_INT);  // DREQ int
#endif

  Serial.println(F("Playing full track 001"));
  musicPlayer.playFullFile("/music.mp3");
}
