ChrisBall/ToffeePhonic/(commit log)

2018-11-11 Basic Framework for site
2018-11-19 finished first draft of build
    menu board section
